WKyleGilbertson/L1IFStream/Card/pcbway/T-2P2W603942A.png

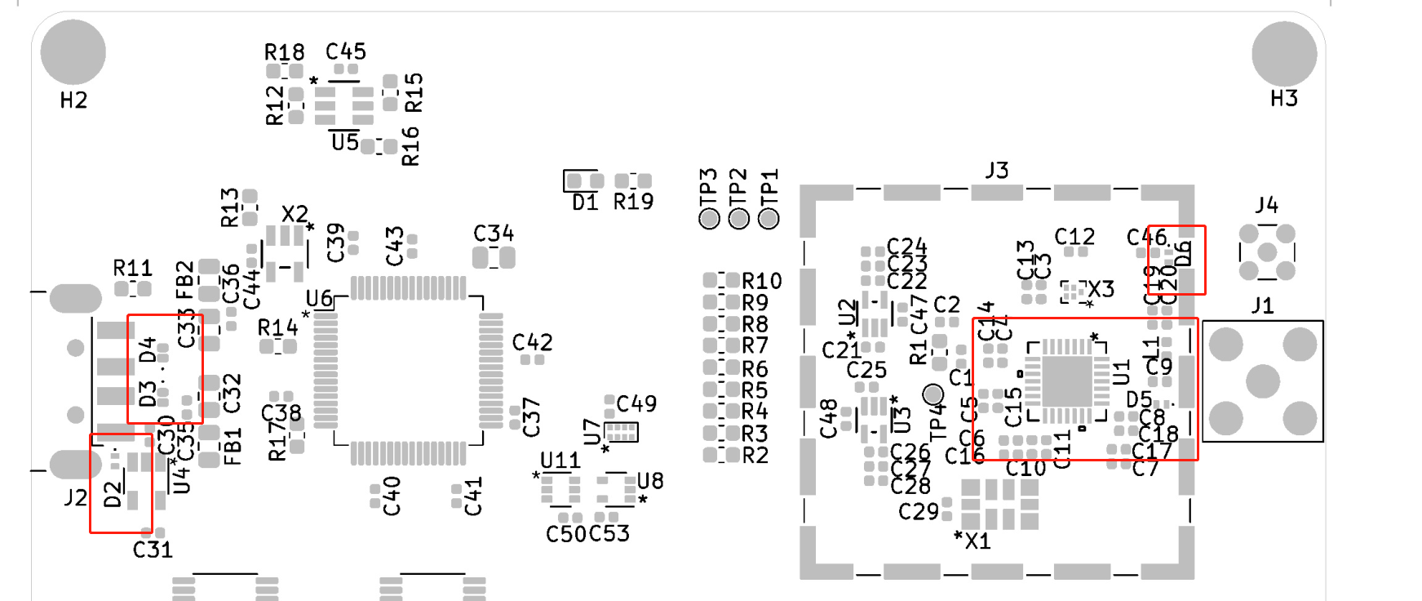
Card/pcbway/T-2P2W603942A.png
