WKyleGilbertson/L1IFStream/Card/pcbway/T-2P2W603942A-5sets-L1IFStream_BOM(2023-07-17-Corrected).xls

PCBWay Bom Quotation, Product No.:T-2P2W603942A
Item # | *Designator | *Qty | *Mfg Part # | Description / Value | Your Instructions / Notes | Substitute | *Unit Price (5 sets) | *Total | *Delivery Time | *Actual Purchase Mfg Part # | *PCBWay Note | Customer Reply | PCBWay Update
1 | C1 | 1 | 490-12651-1-ND | 27 pF『 』L1IFStream-rescue:C-MAX2769FT2232H『 』L1IFStream:C_0402_1005Metric『 』CAP CER 27PF 50V C0G/NP0 0402 5% |  |  | $0.125 | $0.625 |  | GCM1555C1H270JA16D
2 | C2, C9, C46 | 3 | 490-6242-1-ND | 470 pF『 』L1IFStream-rescue:C-MAX2769FT2232H『 』L1IFStream:C_0402_1005Metric『 』CAP CER 470PF 50V C0G/NP0 0402 10% |  |  | $0.051 | $0.765 | 7-10 Workdays | GRM1555C1H471JA01J
3 | C3, C4, C5, C6, C7, C8, C20, C23, C27, C29, C35, C36, C37, C38, C39, C40, C41, C42, C43, C44, C45, C49, C50, C51, C52, C53 | 26 | 490-6328-1-ND | 100 nF『 』L1IFStream-rescue:C-MAX2769FT2232H『 』L1IFStream:C_0402_1005Metric『 』CAP CER 0.1UF 16V X7R 0402 10% |  |  | $0.003 | $0.390 |  | GRM155R71C104KA88J
4 | C10, C11, C47, C48 | 4 | 399-7759-1-ND | 10 nF『 』L1IFStream-rescue:C-MAX2769FT2232H『 』L1IFStream:C_0402_1005Metric『 』CAP CER 10000PF 10V X7R 0402 10% |  |  | $0.050 | $1.000 | 7-10 Workdays | C0402C103K8RAC7867
5 | C12, C22, C26 | 3 |  |  |  |  |  |  |  |  | [DNP不要贴];
6 | C13, C14, C15, C16, C17, C18, C19 | 7 | 399-3194-1-ND | 100 pF『 』L1IFStream-rescue:C-MAX2769FT2232H『 』L1IFStream:C_0402_1005Metric『 』CAP CER 100PF 50V C0G/NP0 0402 5% |  |  | $0.034 | $1.190 | 7-10 Workdays | C0402C101J5GAC7867
7 | C21, C24, C25, C28, C30, C31 | 6 | 490-12233-1-ND | 1.0 uF『 』L1IFStream-rescue:C-MAX2769FT2232H『 』L1IFStream:C_0402_1005Metric『 』CAP CER 1UF 6.3V X6S 0402 |  |  | $0.053 | $1.590 |  | GRT155C80J105KE01D
8 | C32, C33 | 2 | 399-15725-1-ND | 4.7 uF『 』L1IFStream-rescue:C-MAX2769FT2232H『 』L1IFStream:C_0805_2012Metric『 』CAP CER 4.7UF 6.3V X7R 0805 |  |  | $0.453 | $4.530 | 7-10 Workdays | C0805C475J9RACAUTO
9 | C34 | 1 | 490-13309-1-ND | 3.3 uF『 』L1IFStream-rescue:C-MAX2769FT2232H『 』L1IFStream:C_0805_2012Metric『 』CAP CER 3.3UF 16V X7R 0805 |  |  | $0.344 | $1.720 |  | GCM21BR71C335KA73L
10 | D1 | 1 | QBLP601-AG1-2943 | LED『 』L1IFStream:LED_Small_Filled『 』L1IFStream:LED_0603_1608Metric | https://www.digikey.com/en/products/detail/qt-brightek-qtb/QBLP601-AG1-2943/14664280 |  | $0.619 | $3.095 | 7-10 Workdays | QBLP601-AG1-2943
11 | D2 | 1 | 296-TPD1E10B06QDPYRQ1DKR-ND | TPD1E10B06『 』L1IFStream:TPD1E10B06『 』L1IFStream:Texas_DPY0002A_0.6x1mm_P0.65mm『 』TVS DIODE 5.5VWM 14VC 2X1SON『 』14V (Typ) Clamp 6A (8/20Âµs) Ipp Tvs Diode Surface Mount 2-X1SON (1x.60) | https://www.ti.com/product/TPD1E10B06 | TPD1E10B06QDPYRQ1 | $0.328 | $1.640 |  | TPD1E10B06QDPYRQ1
12 | D3, D4 | 2 | 296-51108-6-ND | ESD321『 』L1IFStream:ESD321『 』L1IFStream:DPY-PX1SON_1.0mmx0.6mm『 』TVS DIODE 3.6VWM 6.8VC 2X1SON | https://www.ti.com/product/ESD321 | ESD321DPYR | $0.173 | $1.730 |  | ESD321DPYR
13 | D5, D6 | 2 | 296-TPD1E01B04DPYRQ1DKR-ND | TPD1E01B04『 』L1IFStream:TPD1E01B04『 』L1IFStream:Texas_DPY0002A_0.6x1mm_P0.65mm『 』AUTOMOTIVE 0.18-PF, 3.6-V, 15-KV『 』15V (Typ) Clamp 2.5A (8/20Âµs) Ipp Tvs Diode Surface Mount 2-X1SON (1x.60) | https://www.ti.com/product/TPD1E01B04 | TPD1E01B04DPYRQ1 | $0.300 | $3.000 |  | TPD1E01B04DPYRQ1
14 | FB1, FB2 | 2 | 490-1041-1-ND | Ferrite_Bead『 』L1IFStream-rescue:Ferrite_Bead-MAX2769FT2232H『 』L1IFStream:C_0805_2012Metric『 』FERRITE BEAD 1 KOHM 0805 1LN |  |  | $0.084 | $0.840 |  | BLM21AG102SN1D
15 | H1, H2, H3, H4 | 4 |  | MountingHole_Pad『 』L1IFStream-rescue:MountingHole_Pad-MAX2769FT2232H『 』L1IFStream:MountingHole_2.2mm_M2_Pad_Via |  |  |  |  |  |  | [DNP不要贴];
16 | J1 | 1 | ACX1232-ND | Conn_Coaxial『 』L1IFStream-rescue:Conn_Coaxial-MAX2769FT2232H『 』L1IFStream:SMA_Amphenol_132203-12_Horizontal『 』CONN SMA JACK R/A 50 OHM PCB | ~ |  | $6.160 | $30.800 |  | 132136
17 | J2 | 1 | WM3983CT-ND | USB_A『 』L1IFStream-rescue:USB_A-MAX2769FT2232H『 』L1IFStream:USB_A_CNCTech_1001-011-01101_Horizontal『 』CONN PLUG USB2.0 TYPEA 4P SMD RA | ~ |  | $1.044 | $5.220 |  | 0480372200
18 | J3 | 1 | 903-1008-1-ND | RF_Shield_One_Piece『 』L1IFStream-rescue:RF_Shield_One_Piece-MAX2769FT2232H『 』L1IFStream:Laird_Technologies_BMI-S-103_26.21x26.21mm『 』RF SHIELD 1.032X1.032 SLDR 1PC |  |  | $3.263 | $16.315 | 7-10 Workdays | BMI-S-103
19 | J4 | 1 | ARF1904-ND | Conn_Coaxial『 』L1IFStream-rescue:Conn_Coaxial-MAX2769FT2232H『 』L1IFStream:MMCX_Molex_73415-1471_Vertical『 』CONN MMCX JACK STR 50 OHM PCB | ~ |  | $21.661 | $108.305 | 7-10 Workdays | 908-22106
20 | L1 | 1 | 490-2629-1-ND | 33 nH『 』L1IFStream-rescue:L-MAX2769FT2232H『 』L1IFStream:L_0402_1005Metric『 』FIXED IND 33NH 350MA 580 MOHM |  |  | $0.203 | $1.015 |  | LQG15HS33NJ02D
21 | R1 | 1 | 2019-RK73H1JTTD2002FCT-ND | 20k『 』L1IFStream-rescue:R_US-MAX2769FT2232H『 』L1IFStream:R_0603_1608Metric『 』RES 20K OHM 1% 1/10W 0603 |  |  | $0.208 | $1.040 |  | RK73H1JTTD2002F
22 | R2, R4, R5, R7,R11 | 5 | 2019-RK73Z1JTTDCT-ND | NL『 』L1IFStream-rescue:R_US-MAX2769FT2232H『 』L1IFStream:R_0603_1608Metric『 』RES 0 OHM JUMPER 0603 |  |  | $0.017 | $0.425 | 7-10 Workdays | RK73Z1JTTD
23 | R3, R6, R8, R9, R10 |  |  |  |  |  |  |  |  |  | [DNP不要贴];
24 | R12 | 1 | 2019-RK73H1JTTD2201FCT-ND | 2.2k『 』L1IFStream-rescue:R_US-MAX2769FT2232H『 』L1IFStream:R_0603_1608Metric『 』RES 2.2K OHM 1% 1/10W 0603 |  |  | $0.139 | $0.695 |  | RK73H1JTTD2201F
25 | R13 | 1 | 2019-RK73H1JTTD1001FCT-ND | 1k『 』Device:R_US『 』L1IFStream:R_0603_1608Metric『 』RES 1K OHM 1% 1/8W 0603 | ~ |  | $0.139 | $0.695 |  | RK73H1JTTD1001F
26 | R14 | 1 | 2019-RK73H1JTTD1202FCT-ND | 12k『 』L1IFStream-rescue:R_US-MAX2769FT2232H『 』L1IFStream:R_0603_1608Metric『 』RES 12K OHM 1% 1/10W 0603 |  |  | $0.139 | $0.695 |  | RK73H1JTTD1202F
27 | R15, R16, R18 | 3 | 2019-RK73H1JTTD1002FCT-ND | 10k『 』L1IFStream-rescue:R_US-MAX2769FT2232H『 』L1IFStream:R_0603_1608Metric『 』RES 10K OHM 1% 1/10W 0603 |  |  | $0.032 | $0.480 | 7-10 Workdays | RK73H1JTTD1002F
28 | R17 | 1 | 2019-RK73H1JTTD1001FCT-ND | 1k『 』L1IFStream-rescue:R_US-MAX2769FT2232H『 』L1IFStream:R_0603_1608Metric『 』RES 1K OHM 1% 1/8W 0603 |  |  | $0.139 | $0.695 |  | RK73H1JTTD1001F
29 | R19 | 1 | 2019-RK73H1JTTD3300FDKR-ND | 330『 』L1IFStream-rescue:R_US-MAX2769FT2232H『 』L1IFStream:R_0603_1608Metric『 』RES 330 OHM 1% 1/8W 0603『 』330 Ohms ±1% 0.125W, 1/8W Chip Resistor 0603 (1608 Metric) Automotive AEC-Q200, Moisture Resistant Thick Film |  |  | $0.139 | $0.695 |  | RK73H1JTTD3300F
30 | TP1, TP2, TP3, TP4 | 4 |  | TestPoint『 』Connector:TestPoint『 』L1IFStream:TestPoint_Pad_D1.0mm | ~ |  |  |  |  |  | [DNP不要贴];
31 | U1 | 1 | 175-MAX2769BETI/V+-ND | MAX2769ETI+T『 』L1IFStream-rescue:MAX2769ETI+T-MAX2769FT2232H『 』L1IFStream:MAX2769ETI&plus_T『 』RF RX GNSS 1575.42MHZ 28TQFN『 』- RF Receiver GNSS, GPS 1575.42MHz PCB, Surface Mount 28-TQFN (5x5) | https://www.analog.com/media/en/technical-documentation/data-sheets/MAX2769B.pdf | MAX2769BETI/V+ | $3.753 | $18.765 |  | MAX2769BETI/V+T | MAX2769BETI/V+T is not available. We will supply MAX2769BETI/V+T ok?
32 | U2 | 1 | 296-19649-1-ND | TPS717285DCKR『 』:TPS717285DCKR-MAX2769FT2232H_1『 』L1IFStream:TPS717285DCKR『 』IC REG LINEAR 2.85V 150MA SC70-5 |  |  | $1.162 | $5.810 | 7-10 Workdays | TPS717285DCKR
33 | U3 | 1 | 296-19649-1-ND | TPS717285DCKR『 』L1IFStream-rescue:TPS717285DCKR-MAX2769FT2232H『 』L1IFStream:TPS717285DCKR『 』IC REG LINEAR 2.85V 150MA SC70-5 |  |  | $1.162 | $5.810 | 7-10 Workdays | TPS717285DCKR
34 | U4 | 1 | 488-NCP164CSN330T1GCT-ND | NCP164CSN330T1G『 』L1IFStream-rescue:NCP164CSN330T1G-MAX2769FT2232H『 』L1IFStream:TSOT-23-5『 』LDO 300 MA AD 3.3V, ULTRA | https://www.onsemi.com/pub/Collateral/NCP164C-D.PDF |  | $1.369 | $6.845 | 7-10 Workdays | NCP164CSN330T1G
35 | U5 | 1 | 93LC66BT-I/OTCT-ND | 93LC66BT-I_OT『 』L1IFStream-rescue:93LC66BT-I_OT-MAX2769FT2232H『 』L1IFStream:93LC66BT-I&slash_OT『 』IC EEPROM 4K SPI 2MHZ SOT23-6 |  |  | $0.538 | $2.690 | 7-10 Workdays | 93LC66BT-I/OT
36 | U6 | 1 | 768-1024-1-ND | FT2232H-Interface_USB『 』L1IFStream-rescue:FT2232H-Interface_USB-MAX2769FT2232H『 』L1IFStream:LQFP-64_10x10mm_P0.5mm『 』IC USB HS DUAL UART/FIFO 64-LQFP |  |  | $6.594 | $32.970 |  | FT2232HL-REEL
37 | U7 | 1 | 1727-3558-1-ND | 74LVC1G74『 』L1IFStream-rescue:74LVC1G74-MAX2769FT2232H『 』L1IFStream:SOT-833-1『 』IC FF D-TYPE SNGL 1BIT 8XSON | https://assets.nexperia.com/documents/data-sheet/74LVC1G74.pdf |  | $0.282 | $1.410 |  | 74LVC1G74GT,115
38 | U8 | 1 | 1727-2871-1-ND | 74LVC1G04『 』L1IFStream-rescue:74LVC1G04-MAX2769FT2232H『 』L1IFStream:SOT-353_SC-70-5『 』IC INVERTER 1CH 1-INP 5TSSOP | https://assets.nexperia.com/documents/data-sheet/74LVC1G04.pdf |  | $0.171 | $0.855 |  | 74LVC1G04GW,125
39 | U9, U10 | 2 | 1727-4034-1-ND | 74LVC374『 』L1IFStream-rescue:74LVC374-MAX2769FT2232H『 』L1IFStream:TSSOP-20_4.4x6.5mm_P0.65mm『 』IC FF D-TYPE SNGL 8BIT 20TSSOP | https://assets.nexperia.com/documents/data-sheet/74LVC374A.pdf |  | $0.259 | $2.590 |  | 74LVC374APW,118
40 | U11 | 1 | 1727-6915-6-ND | 74HC2G04『 』:74HC2G04-MAX2769FT2232H_2『 』L1IFStream:SOT-363_SC-70-6『 』IC INVERTER 2CH 2-INP 6TSSOP | https://assets.nexperia.com/documents/data-sheet/74HC_HCT2G04.pdf |  | $0.635 | $3.175 | 7-10 Workdays | 74HC2GU04GW,125 | We will supply 74HC2GU04GW,125,pls confirm.
41 | X1 | 1 | 1473-SIT5156AICFK-30N0-16.368000-ND | SIT5156『 』L1IFStream:SIT5156AICFA-30N0-16.368000_1『 』L1IFStream:10L_CQFN | https://www.sitime.com/support/resource-library/datasheets/sit5156-datasheet | SIT5156AICFK-30N0-16.368000 | $59.622 | $298.110 | 7-10 Workdays | SIT5156AICFK-30N0-16.368000
42 | X2 | 1 | 1473-SIT2024BA-S8-33E-12.000000G-ND | SIT2024BA-S8-33E-12.00000E『 』L1IFStream-rescue:SIT2024BA-S8-33E-12.00000E-MAX2769FT2232H『 』L1IFStream:SIT2024BA-S8-33E-12.000000E『 』MEMS OSC XO 12.0000MHZ LVCMOS LV |  |  |  |  |  | SIT2024BA-S8-33E-12.000000 | [Supplied by customer客供];
43 | X3 | 1 | 772-QPQ1060SR | QPQ1060『 』L1IFStream:QPQ1060『 』L1IFStream:QPQ1060_1.4x1.2 | https://www.qorvo.com/products/p/QPQ1060 |  |  |  |  | QPQ1060SR | [Supplied by customer客供];
 |  |  |  |  |  |  | Component Cost | $568.220
 |  |  |  |  |  |  | PCB cost | $277.670
 |  |  |  |  |  |  | Assembly cost | $30.000
 |  |  |  |  |  |  | PCBA in total | $875.890
