WKyleGilbertson/L1IFStream/Card/macrofab/L1IFStream_BOM.xlsx

Component Count: |  | 107
Collated Components:
Item | Description | Qty | Reference(s) | Value | Manufacturer | MPN | Vendor | Vendor P/N# | Notes
1 | CAP CER 27PF 50V C0G/NP0 0402 5% | 1 | C1 | 27 pF | Murata | GCM1555C1H270JA16D | DigiKey | 490-12651-1-ND
2 | CAP CER 470PF 50V C0G/NP0 0402 10% | 3 | C2, C9, C46 | 470 pF | Murata | GRM1555C1H471JA01J | DigiKey | 490-6242-1-ND
3 | CAP CER 0.1UF 16V X7R 0402 10% | 26 | C3, C4, C5, C6, C7, C8, C20, C23, C27, C29, C35, C36, C37, C38, C39, C40, C41, C42, C43, C44, C45, C49, C50, C51, C52, C53 | 100 nF | Murata | GRM155R71C104KA88J | DigiKey | 490-6328-1-ND
4 | CAP CER 10000PF 10V X7R 0402 10% | 4 | C10, C11, C47, C48 | 10 nF | Kemet | C0402C103K8RAC7867 | DigiKey | 399-7759-1-ND
5 | CAP CER 470PF 50V C0G/NP0 0402 10% | 3 | C12, C22, C26 | NL | DNP | DNP | DNP | DNP | DNP
6 | CAP CER 100PF 50V C0G/NP0 0402 5% | 7 | C13, C14, C15, C16, C17, C18, C19 | 100 pF | Kemet | C0402C101J5GAC7867 | DigiKey | 399-3194-1-ND
7 | CAP CER 1UF 6.3V X6S 0402 | 6 | C21, C24, C25, C28, C30, C31 | 1.0 uF | Murata | GRT155C80J105KE01D | DigiKey | 490-12233-1-ND
8 | CAP CER 4.7UF 6.3V X7R 0805 | 2 | C32, C33 | 4.7 uF | Kemet | C0805C475J9RACAUTO | DigiKey | 399-15725-1-ND
9 | CAP CER 3.3UF 16V X7R 0805 | 1 | C34 | 3.3 uF | Murata | GCM21BR71C335KA73L | DigiKey | 490-13309-1-ND
10 |  | 1 | D1 | LED | QTBrightek (QTB) | QBLP601-AG1-2943 | DigiKey | QBLP601-AG1-2943
11 | TVS DIODE 5.5VWM 14VC 2X1SON | 1 | D2 | TPD1E10B06 | Texas Instruments | TPD1E10B06QDPYRQ1 | DigiKey | 296-TPD1E10B06QDPYRQ1DKR-ND
12 | TVS DIODE 3.6VWM 6.8VC 2X1SON | 2 | D3, D4 | ESD321 | Texas Instruments | ESD321DPYR | DigiKey | 296-51108-6-ND
13 | AUTOMOTIVE 0.18-PF, 3.6-V, 15-KV | 2 | D5, D6 | TPD1E01B04 | Texas Instruments | TPD1E01B04DPYRQ1 | DigiKey | 296-TPD1E01B04DPYRQ1DKR-ND
14 | FERRITE BEAD 1 KOHM 0805 1LN | 2 | FB1, FB2 | Ferrite_Bead | Murata | BLM21AG102SN1D | DigiKey | 490-1041-1-ND
15 |  | 4 | H1, H2, H3, H4 | MountingHole_Pad | PCB MFR |  | MFR
16 | CONN SMA JACK R/A 50 OHM PCB | 1 | J1 | Conn_Coaxial | Amphenol RF | 132136 | DigiKey | ACX1232-ND
17 | CONN PLUG USB2.0 TYPEA 4P SMD RA | 1 | J2 | USB_A | Molex | 480372200 | DigiKey | WM3983CT-ND
18 | RF SHIELD 1.032"X1.032" SLDR 1PC | 1 | J3 | RF_Shield_One_Piece | Laird Technologies EMI | BMI-S-103 | DigiKey | 903-1008-1-ND
19 | CONN MMCX JACK STR 50 OHM PCB | 1 | J4 | Conn_Coaxial | Amphenol RF | 908-22106 | DigiKey | ARF1904-ND
20 | FIXED IND 33NH 350MA 580 MOHM | 1 | L1 | 33 nH | Murata | LQG15HS33NJ02D | DigiKey | 490-2629-1-ND
21 | RES 20K OHM 1% 1/10W 0603 | 1 | R1 | 20k | KOA Speer Electronics, Inc. | RK73H1JTTD2002F | DigiKey | 2019-RK73H1JTTD2002FCT-ND
22 | RES 0 OHM JUMPER 0603 | 5 | R2, R4, R5, R7, R11 | 0 | KOA Speer Electronics, Inc. | RK73Z1JTTD | DigiKey | 2019-RK73Z1JTTDCT-ND
23 | RES 0 OHM JUMPER 0603 | 5 | R3, R6, R8, R9, R10 | NL | DNP | DNP | DNP | DNP | DNP
24 | RES 2.2K OHM 1% 1/10W 0603 | 1 | R12 | 2.2k | KOA Speer Electronics, Inc. | RK73H1JTTD2201F | DigiKey | 2019-RK73H1JTTD2201FCT-ND
25 | RES 1K OHM 1% 1/8W 0603 | 1 | R13 | 1k | KOA Speer Electronics, Inc. | RK73H1JTTD1001F | DigiKey | 2019-RK73H1JTTD1001FCT-ND
26 | RES 12K OHM 1% 1/10W 0603 | 1 | R14 | 12k | KOA Speer Electronics, Inc. | RK73H1JTTD1202F | DigiKey | 2019-RK73H1JTTD1202FCT-ND
27 | RES 10K OHM 1% 1/10W 0603 | 3 | R15, R16, R18 | 10k | KOA Speer Electronics, Inc. | RK73H1JTTD1002F | DigiKey | 2019-RK73H1JTTD1002FCT-ND
28 | RES 1K OHM 1% 1/8W 0603 | 1 | R17 | 1k | KOA Speer Electronics, Inc. | RK73H1JTTD1001F | DigiKey | 2019-RK73H1JTTD1001FCT-ND
29 | RES 330 OHM 1% 1/8W 0603 | 1 | R19 | 330 | KOA Speer Electronics, Inc. | RK73H1JTTD3300F | DigiKey | 2019-RK73H1JTTD3300FDKR-ND
30 |  | 4 | TP1, TP2, TP3, TP4 | TestPoint | PCB MFR |  | MFR
31 | RF RX GNSS 1575.42MHZ 28TQFN | 1 | U1 | MAX2769ETI+T | Analog Devices Inc./ Maxim Integrated | MAX2769BETI/V+ | DigiKey | 175-MAX2769BETI/V+-ND
32 | IC REG LINEAR 2.85V 150MA SC70-5 | 2 | U2, U3 | TPS717285DCKR | Texas Instruments | TPS717285DCKR | DigiKey | 296-19649-1-ND
33 | LDO 300 MA AD 3.3V, ULTRA | 1 | U4 | NCP164CSN330T1G | Onsemi | NCP164CSN330T1G | DigiKey | 488-NCP164CSN330T1GCT-ND
34 | IC EEPROM 4K SPI 2MHZ SOT23-6 | 1 | U5 | 93LC66BT-I_OT | Microchip | 93LC66BT-I/OT | DigiKey | 93LC66BT-I/OTCT-ND
35 | IC USB HS DUAL UART/FIFO 64-LQFP | 1 | U6 | FT2232H-Interface_USB | FTDI | FT2232HL-REEL | DigiKey | 768-1024-1-ND
36 | IC FF D-TYPE SNGL 1BIT 8XSON | 1 | U7 | 74LVC1G74 | Nexperia | 74LVC1G74GT,115 | DigiKey | 1727-3558-1-ND
37 | IC INVERTER 1CH 1-INP 5TSSOP | 1 | U8 | 74LVC1G04 | Nexperia | 74LVC1G04GW,125 | DigiKey | 1727-2871-1-ND
38 | IC FF D-TYPE SNGL 8BIT 20TSSOP | 2 | U9, U10 | 74LVC374 | Nexperia | 74LVC374APW,118 | DigiKey | 1727-4034-1-ND
39 | IC INVERTER 2CH 2-INP 6TSSOP | 1 | U11 | 74HC2GU04 | Nexperia | 74HC2GU04GW,125 | DigiKey | 1727-6915-6-ND
40 | MEMS OSC TCXO 16.3680MHZ | 1 | X1 | SIT5156 | SiTime | SIT5156AICFK-30N0-16.368000 | DigiKey | 1473-SIT5156AICFK-30N0-16.368000-ND
41 | MEMS OSC XO 12.0000MHZ LVCMOS LV | 1 | X2 | SIT2024BA-S8-33E-12.00000E | SiTime | SIT2024BA-S8-33E-12.000000 | DigiKey | 1473-SIT2024BA-S8-33E-12.000000G-ND
42 | Signal Conditioning L1 TC-SAW, GSO | 1 | X3 | QPQ1060 | Qorvo | QPQ1060SR | Mouser | 772-QPQ1060SR
Source: |  | C:\git\GPS\L1IFStream\Card\L1IFStream.kicad_sch
Date: |  | 2023-07-12 10:48
Tool: |  | Eeschema 7.0.6
Generator: |  | C:\Programs\KiCad\7.0\bin\scripting\plugins/bom_csv_grouped_by_value.py
