WKyleGilbertson/L1IFStream/Card/pcbway/parts.txt

5 maxim chips
5 qorvo chips
5 SiTime chips
