WKyleGilbertson/L1IFStream/Card/STEP/TSSOP-20_4.4x6.5mm_P0.65mm.step

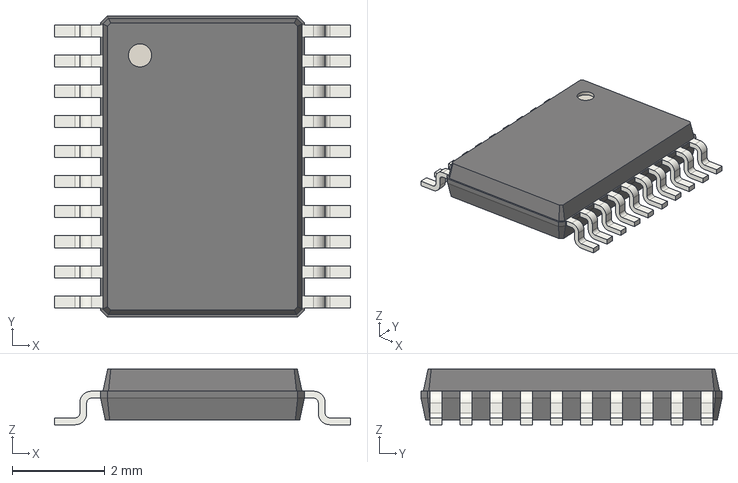
[picture p2: CAD file, 2023-11-13]
Card/STEP/TSSOP-20_4.4x6.5mm_P0.65mm.step
6.40 x 6.50 x 1.20 mm
