WKyleGilbertson/L1IFStream/Card/STEP/SOT833-1.step

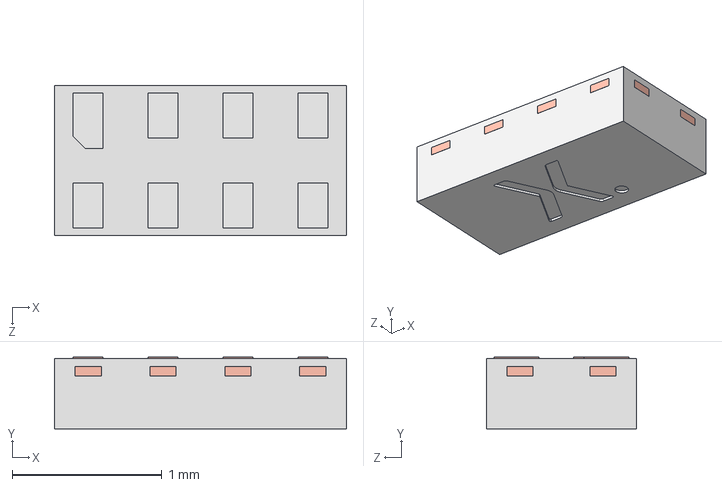
[picture p3: CAD file, 2023-11-13]
Card/STEP/SOT833-1.step
1.95 x 0.48 x 1.00 mm
SOT833-1 LF
SOT833-1 Mold body
