WKyleGilbertson/L1IFStream/Card/STEP/SOT-363_SC-70-6.step

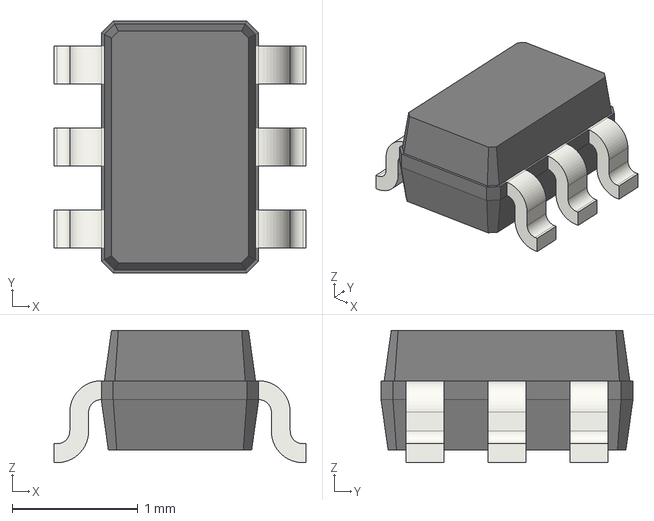
[picture p4: CAD file, 2023-11-13]
Card/STEP/SOT-363_SC-70-6.step
2.00 x 2.00 x 1.05 mm
