WKyleGilbertson/L1IFStream/Card/STEP/SOT-353_SC-70-5.step

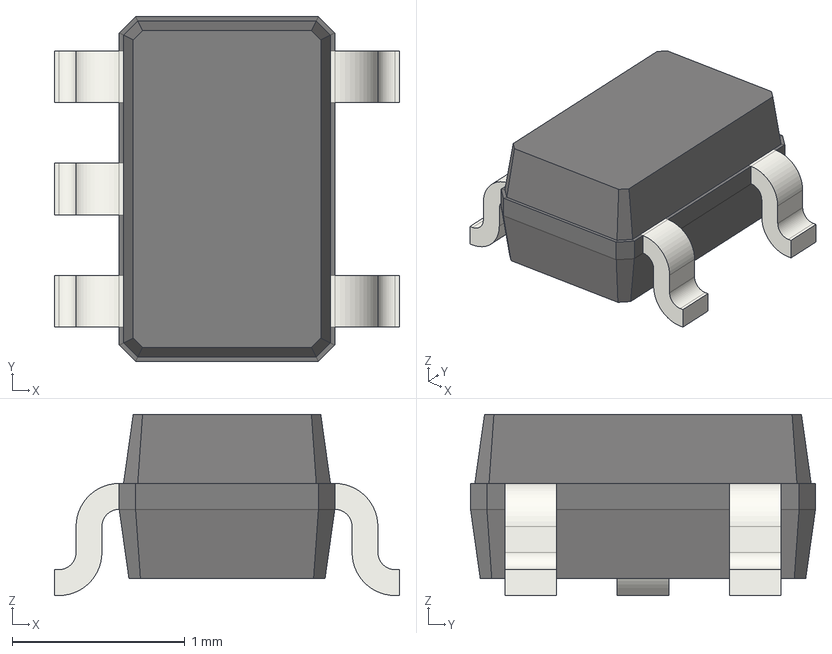
[picture p5: CAD file, 2023-11-13]
Card/STEP/SOT-353_SC-70-5.step
2.00 x 2.00 x 1.05 mm
