WKyleGilbertson/L1IFStream/Card/STEP/MMCX_Molex_73415-1471_Vertical.step

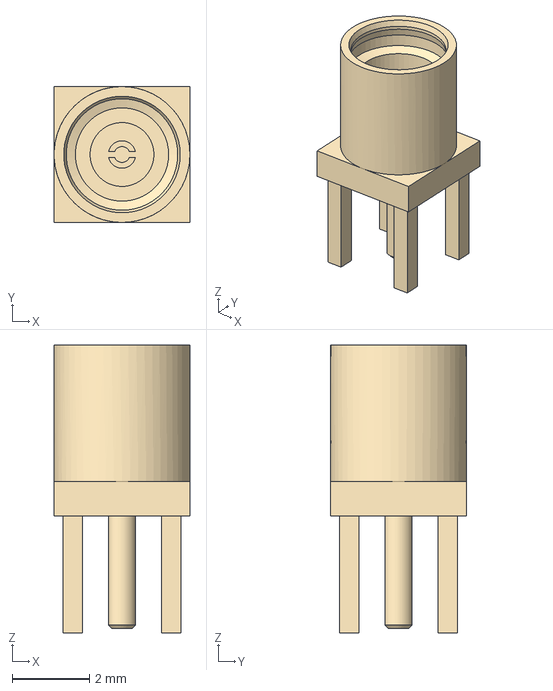
[picture p6: CAD file, 2023-11-13]
Card/STEP/MMCX_Molex_73415-1471_Vertical.step
3.51 x 3.51 x 7.44 mm
