WKyleGilbertson/L1IFStream/Card/STEP/LQFP-64_10x10mm_P0.5mm.step

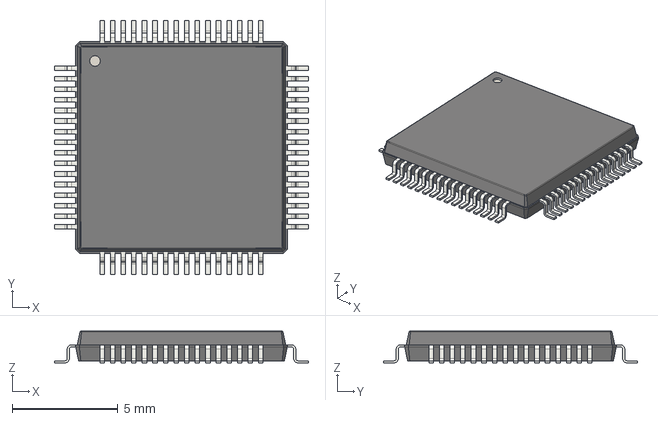
[picture p7: CAD file, 2023-11-13]
Card/STEP/LQFP-64_10x10mm_P0.5mm.step
12.0 x 12.0 x 1.50 mm
