WKyleGilbertson/L1IFStream/Card/STEP/DCK0005A.stp

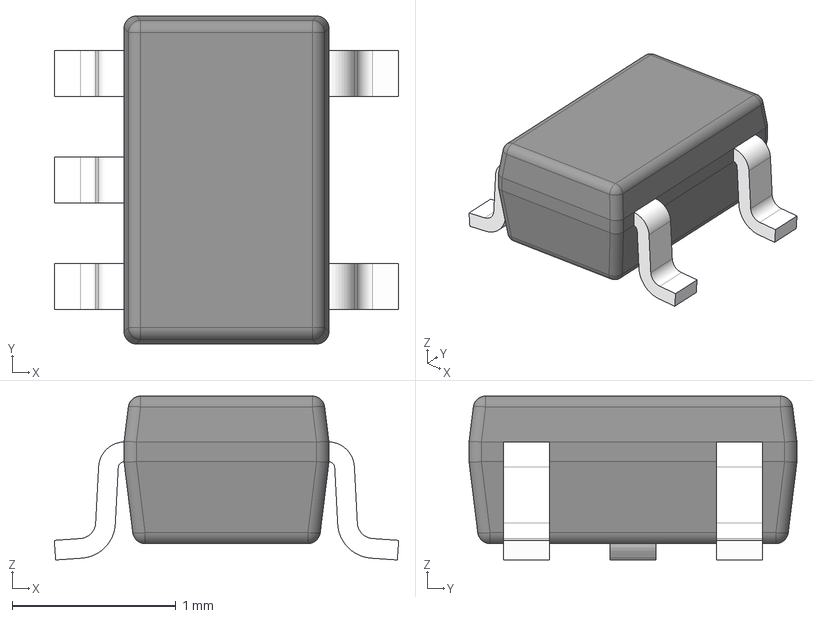
[picture p8: CAD file, 2023-11-09]
Card/STEP/DCK0005A.stp
2.10 x 2.00 x 1.00 mm
BODY-SOT
LEAD-SOT x 5
PIN1-ID
