WKyleGilbertson/L1IFStream/Card/STEP/Laird-BMI-S-103-1.STEP

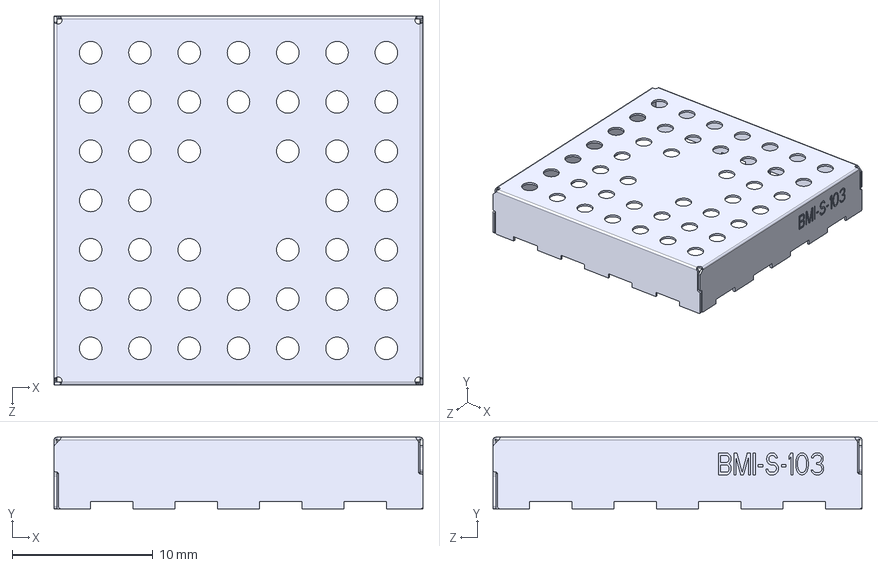
[picture p9: CAD file, 2023-07-18]
Card/STEP/Laird-BMI-S-103-1.STEP
26.2 x 5.08 x 26.2 mm
