WKyleGilbertson/L1IFStream/Card/STEP/QFN-28-1EP_5x5mm_P0.5mm_EP3.35x3.35mm.step

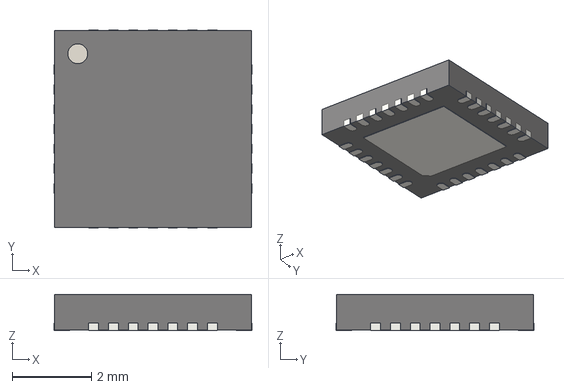
[picture p10: CAD file, 2023-07-18]
Card/STEP/QFN-28-1EP_5x5mm_P0.5mm_EP3.35x3.35mm.step
5.00 x 5.00 x 0.92 mm
