WKyleGilbertson/L1IFStream/Card/STEP/SOT-23-6.step

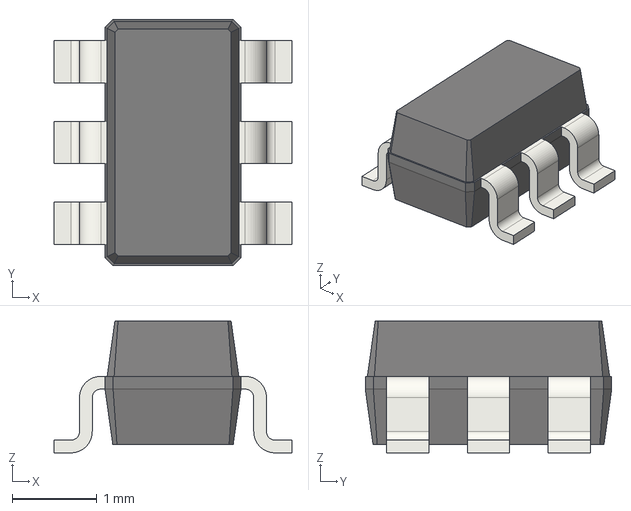
[picture p11: CAD file, 2023-07-18]
Card/STEP/SOT-23-6.step
2.80 x 2.90 x 1.55 mm
