WKyleGilbertson/L1IFStream/Card/STEP/Oscillator_SMD_IDT_JS6-6_5.0x3.2mm_P1.27mm.step

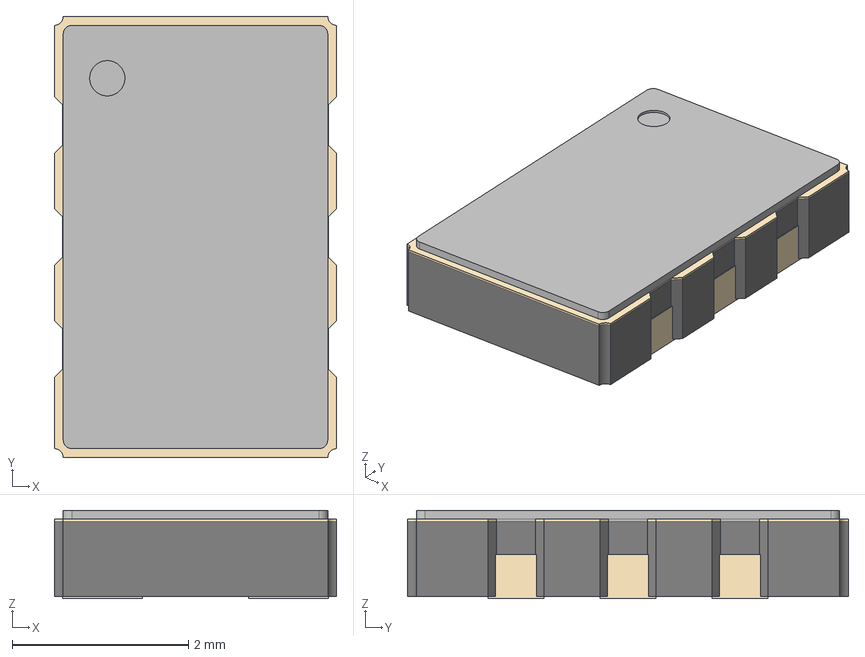
[picture p12: CAD file, 2023-07-18]
Card/STEP/Oscillator_SMD_IDT_JS6-6_5.0x3.2mm_P1.27mm.step
3.20 x 5.00 x 1.00 mm
