WKyleGilbertson/L1IFStream/Card/STEP/SOT-23-5.step

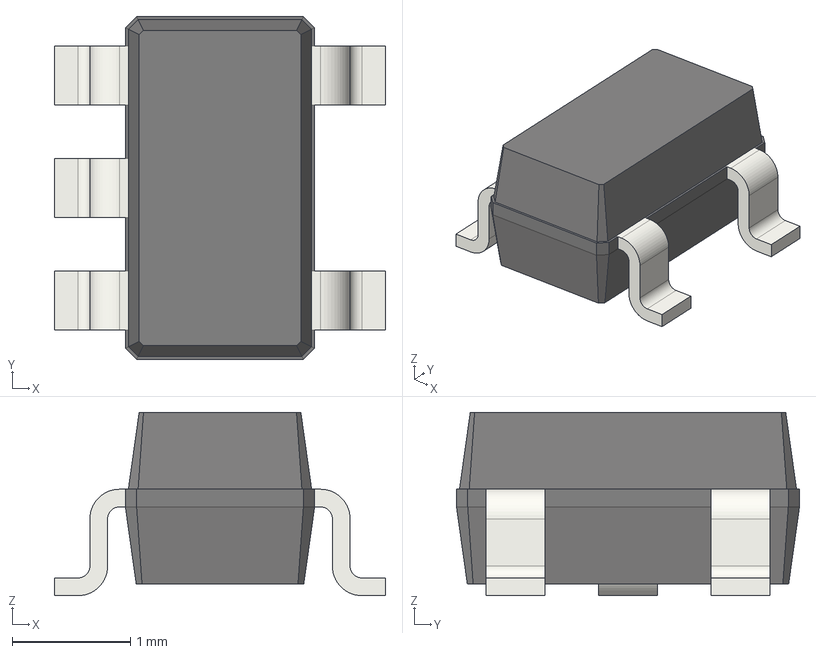
[picture p13: CAD file, 2023-07-18]
Card/STEP/SOT-23-5.step
2.80 x 2.90 x 1.55 mm
