WKyleGilbertson/L1IFStream/Card/STEP/DPY0002A.stp

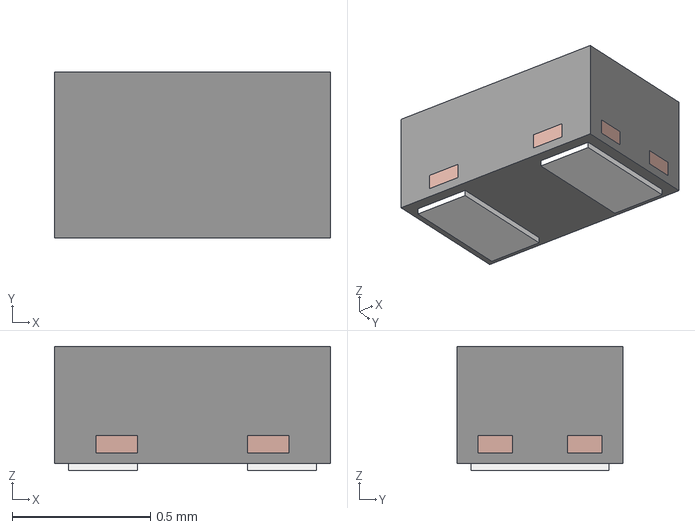
[picture p14: CAD file, 2023-07-18]
Card/STEP/DPY0002A.stp
1.00 x 0.6 x 0.45 mm
BODY-SON
FRAME-DPY0002A
