WKyleGilbertson/L1IFStream/Card/STEP/QPQ1060SR.stp

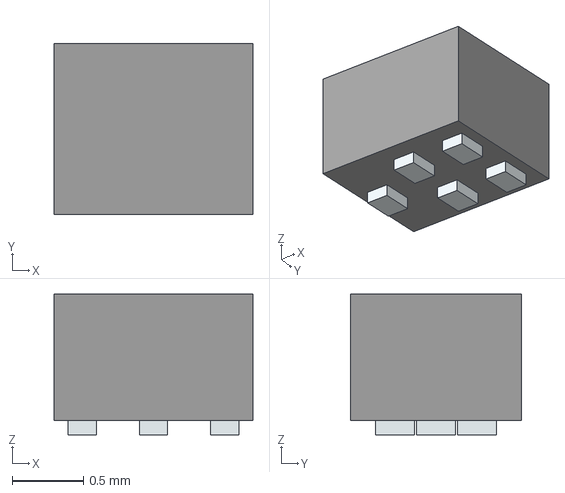
[picture p15: CAD file, 2023-07-13]
Card/STEP/QPQ1060SR.stp
1.40 x 1.20 x 0.99 mm
Pins
