WKyleGilbertson/L1IFStream/Card/STEP/SMA-J-P-X-RA-TH1.step

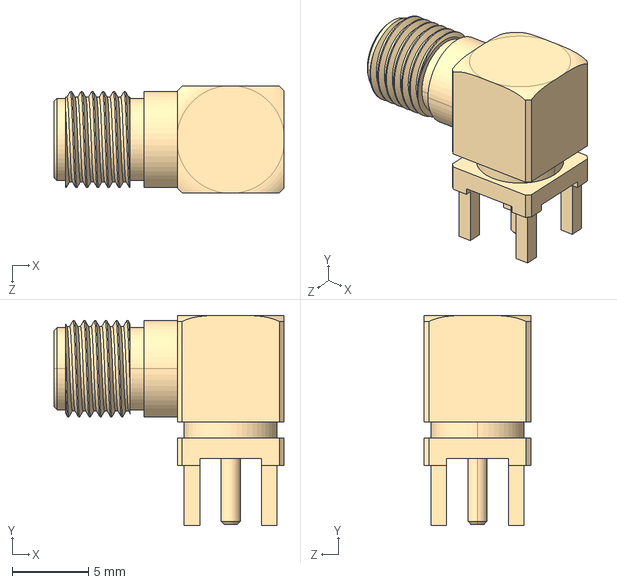
[picture p16: CAD file, 2023-07-10]
Card/STEP/SMA-J-P-X-RA-TH1.step
15.1 x 13.8 x 7.00 mm
