WKyleGilbertson/L1IFStream/Card/STEP/1001-011-01101.STEP

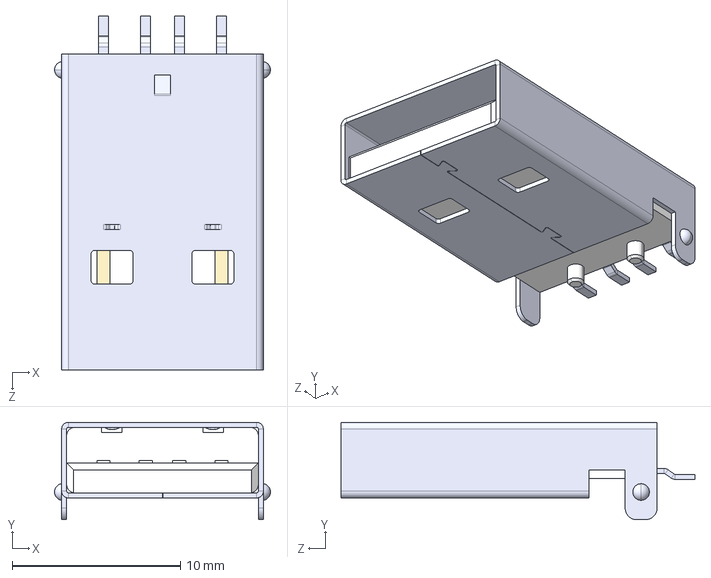
[picture p17: CAD file, 2023-07-10]
Card/STEP/1001-011-01101.STEP
12.8 x 5.80 x 21.1 mm
