WKyleGilbertson/L1IFStream/Card/macrofab/Assy.pdf

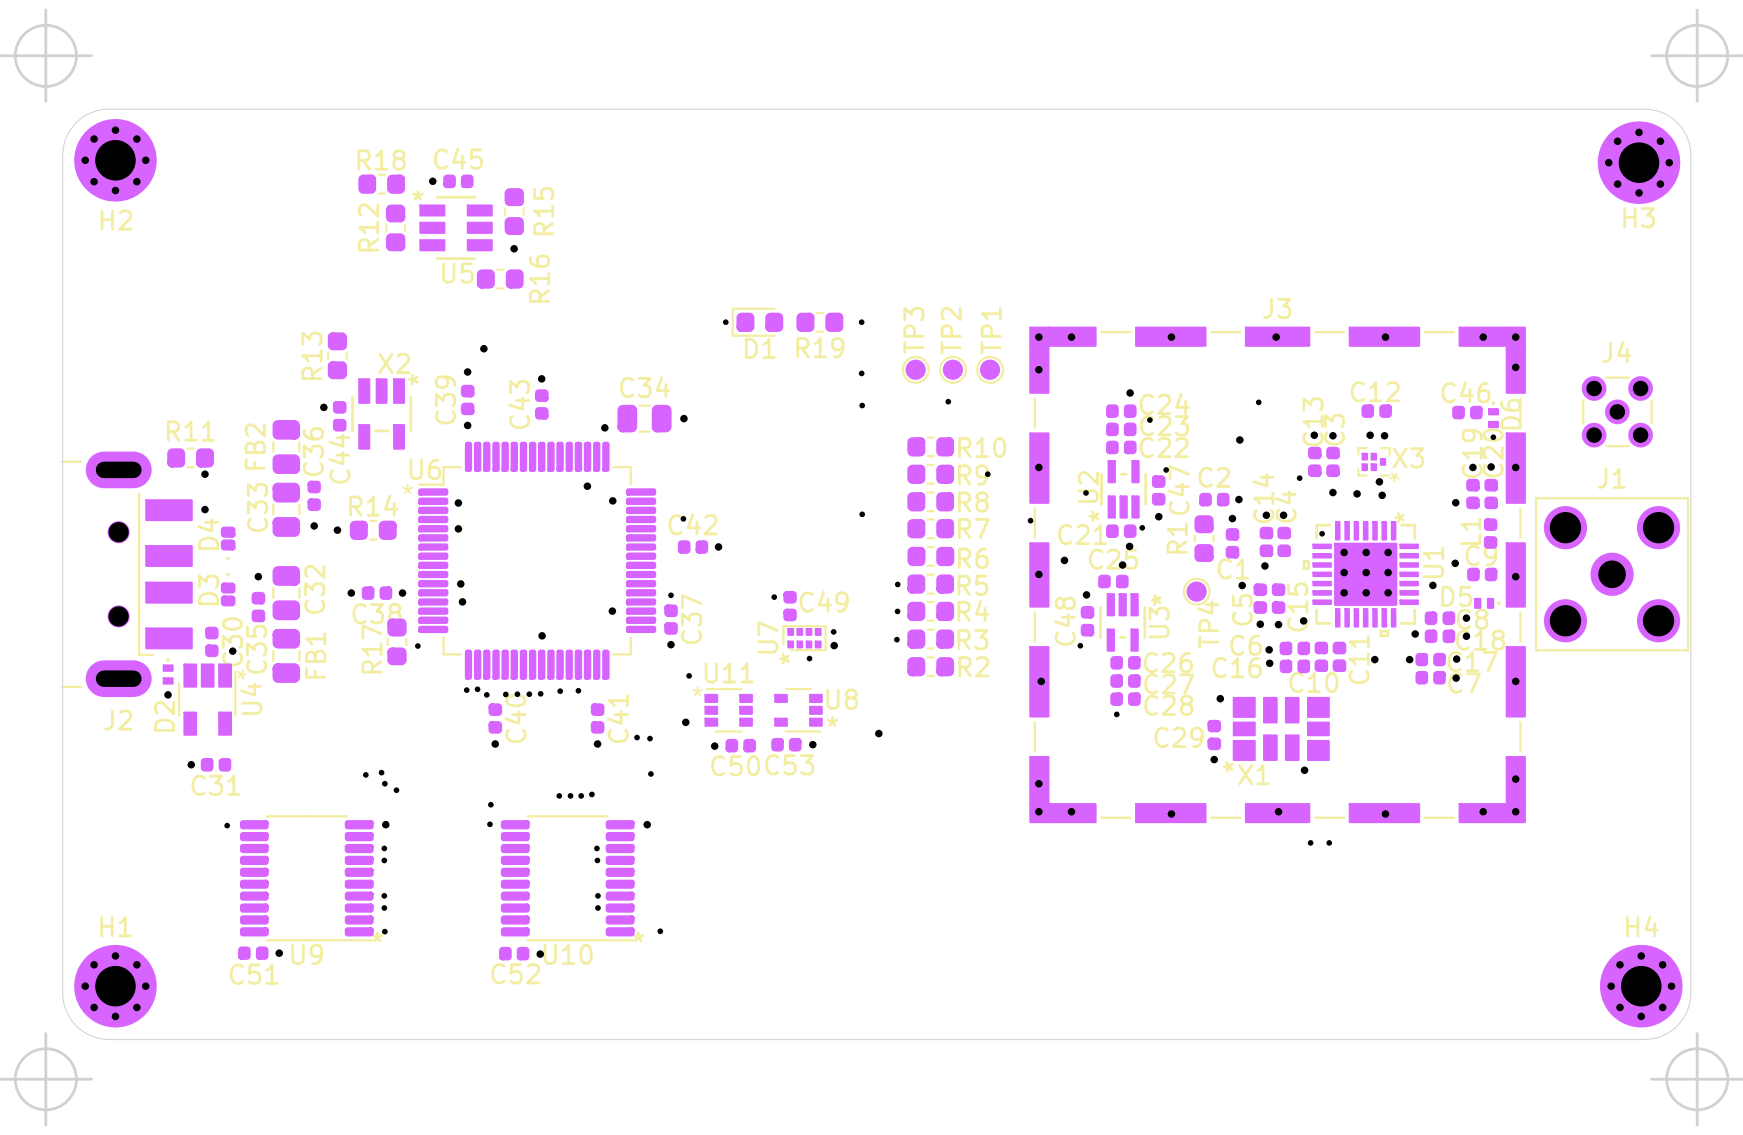
[picture p19: page 1]
