WKyleGilbertson/L1IFStream/Card/L1IFStream.kicad_pcb

## KiCad design Card/L1IFStream.kicad_pcb (2024-02-13)

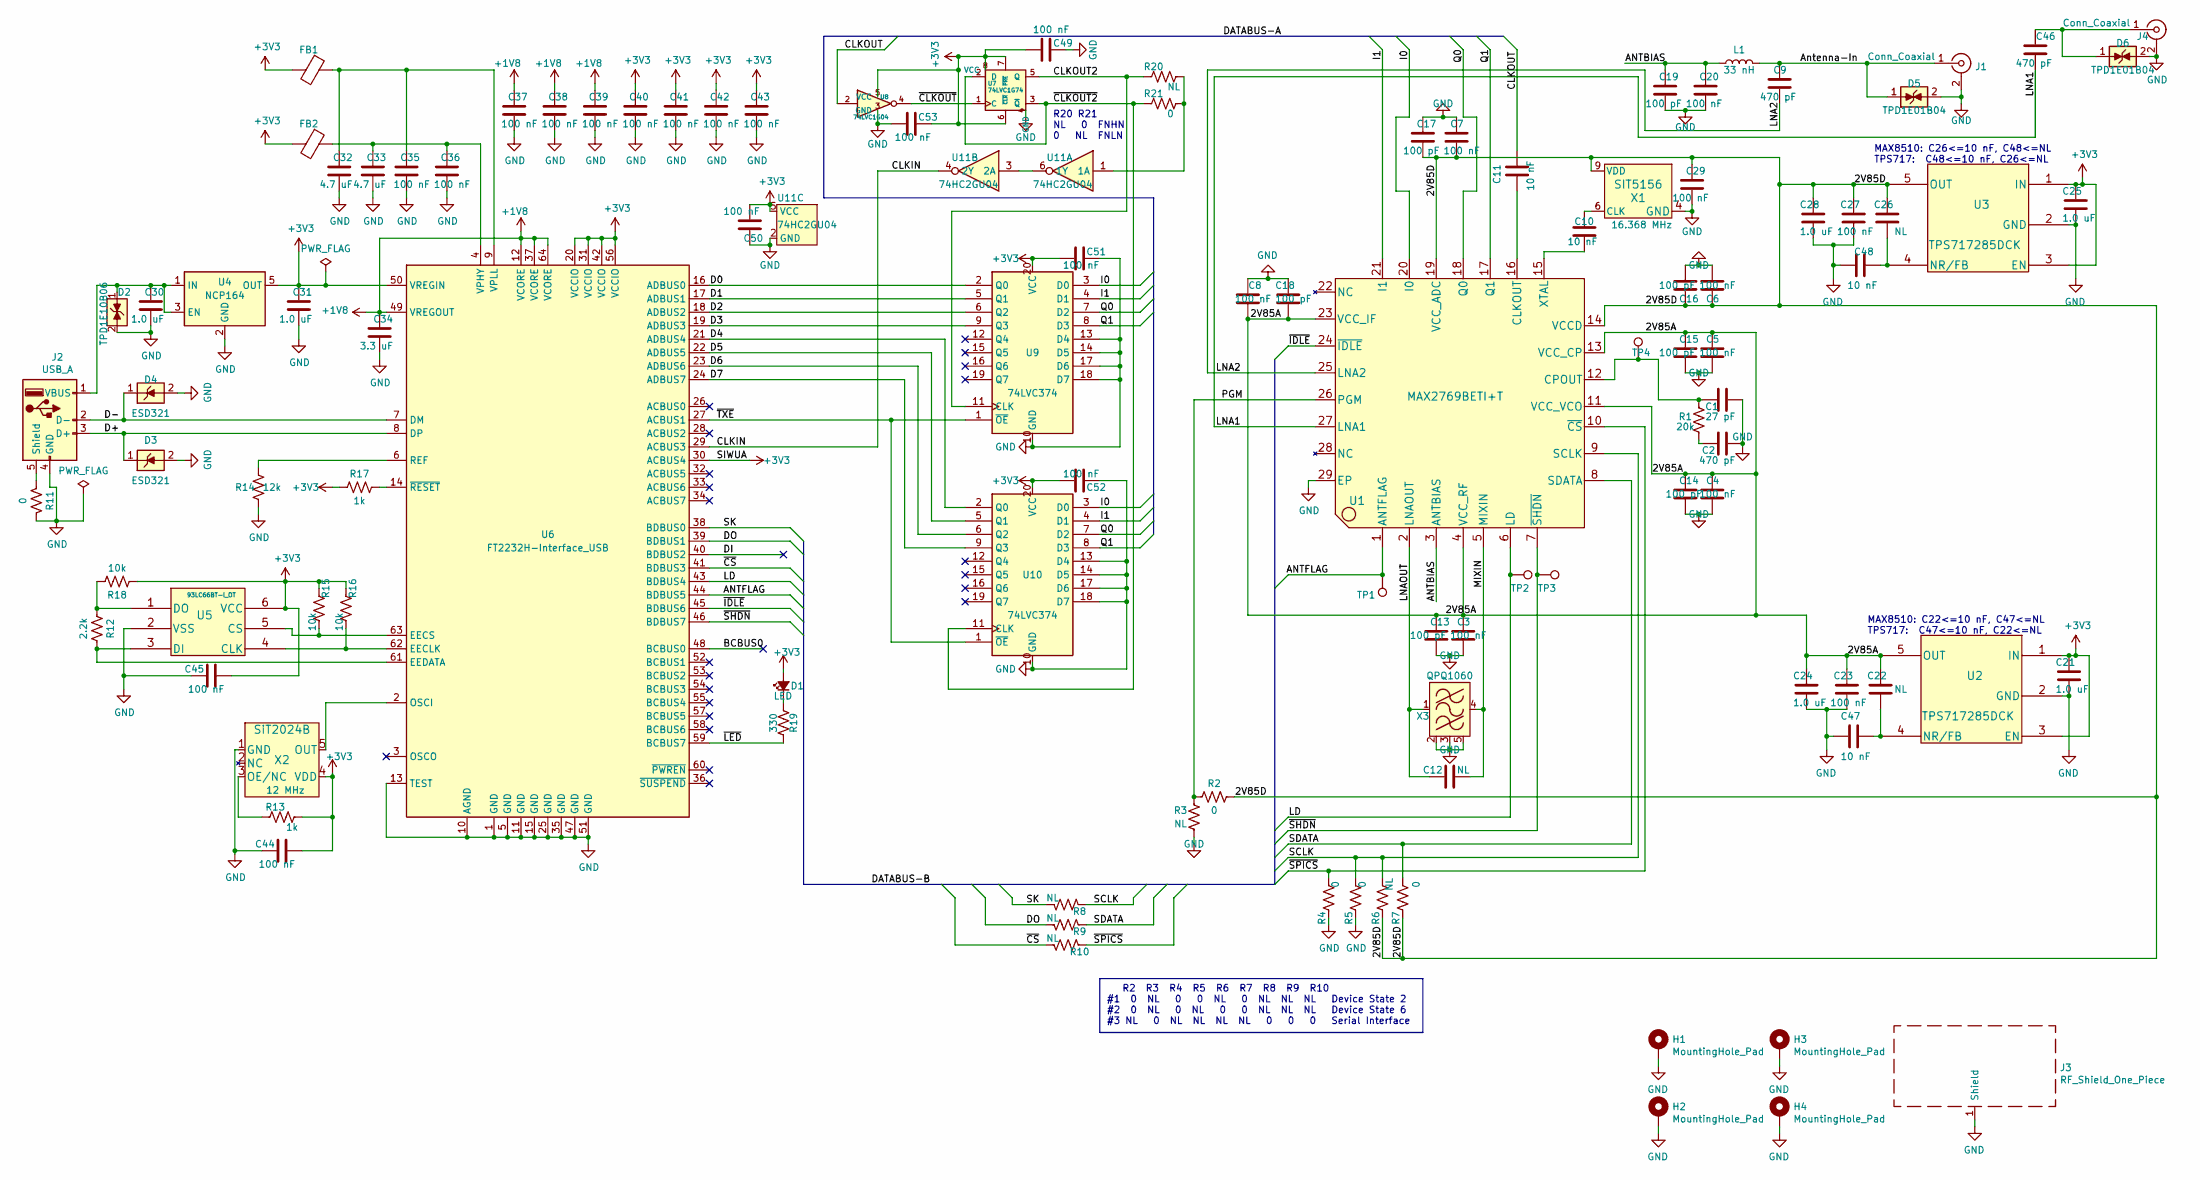
[picture p20: schematic L1IFStream.kicad_sch, L1 IF Stream]

Parts:
C1: 27 pF; C_0402_1005Metric; MPN GCM1555C1H270JA16D
C2, C9, C46: 470 pF; C_0402_1005Metric; MPN GRM1555C1H471JA01J
C3, C4, C5, C6, C7, C8, C20, C23, C27, C29, C35, C36, C37, C38, C39, C40, C41, C42, C43, C44, C45, C49, C50, C51, C52, C53: 100 nF; C_0402_1005Metric; MPN GRM155R71C104KA88J
C10, C11, C47, C48: 10 nF; C_0402_1005Metric; MPN C0402C103K8RAC7867
C12: NL; C_0402_1005Metric; MPN GRM1555C1H471JA01J
C13, C14, C15, C16, C17, C18, C19: 100 pF; C_0402_1005Metric; MPN C0402C101J5GAC7867
C21, C24, C25, C28, C30, C31: 1.0 uF; C_0402_1005Metric; MPN GRT155C80J105KE01D
C22, C26: NL; C_0402_1005Metric; MPN C0402C103K8RAC7867
C32, C33: 4.7 uF; C_0805_2012Metric; MPN C0805C475J9RACAUTO
C34: 3.3 uF; C_0805_2012Metric; MPN GCM21BR71C335KA73L
D1: LED; LED_0603_1608Metric; MPN QBLP601-AG1-2943
D2: TPD1E10B06; Texas_DPY0002A_0.6x1mm_P0.65mm; MPN TPD1E10B06QDPYRQ1
D3, D4: ESD321; Texas_DPY0002A_0.6x1mm_P0.65mm; MPN ESD321DPYR
D5, D6: TPD1E01B04; Texas_DPY0002A_0.6x1mm_P0.65mm; MPN TPD1E01B04DPYRQ1
FB1, FB2: Ferrite_Bead; C_0805_2012Metric; MPN BLM21AG102SN1D
H1, H2, H3, H4: MountingHole_Pad; MountingHole_2.2mm_M2_Pad_Via
J1: Conn_Coaxial; SMA_Amphenol_132203-12_Horizontal; MPN 132136
J2: USB_A; USB_A_CNCTech_1001-011-01101_Horizontal; MPN 0480372200
J3: RF_Shield_One_Piece; Laird_Technologies_BMI-S-103_26.21x26.21mm; MPN BMI-S-103
J4: Conn_Coaxial; MMCX_Molex_73415-1471_Vertical; MPN 908-22106
L1: 33 nH; L_0402_1005Metric; MPN LQG15HS33NJ02D
R1: 20k; R_0603_1608Metric; MPN RK73H1JTTD2002F
R2, R4, R5, R7, R11, R21: 0; R_0603_1608Metric; MPN RK73Z1JTTD
R3, R6, R8, R9, R10, R20: NL; R_0603_1608Metric; MPN RK73Z1JTTD
R12: 2.2k; R_0603_1608Metric; MPN RK73H1JTTD2201F
R13, R17: 1k; R_0603_1608Metric; MPN RK73H1JTTD1001F
R14: 12k; R_0603_1608Metric; MPN RK73H1JTTD1202F
R15, R16, R18: 10k; R_0603_1608Metric; MPN RK73H1JTTD1002F
R19: 330; R_0603_1608Metric; MPN RK73H1JTTD3300F
TP1, TP2, TP3, TP4: TestPoint; TestPoint_Pad_D1.0mm
U1: MAX2769BETI+T; QFN-28_EP_5.63x5.63_Pitch0.5mm; MPN MAX2769BETI/V+
U2, U3: TPS717285DCK; MPN TPS717285DCK
U4: NCP164; TSOP-5; MPN NCP164CSN330T1G
U5: 93LC66BT-I_OT; SOT-23-6; MPN 93LC66BT-I/OT
U6: FT2232H-Interface_USB; LQFP-64_10x10mm_P0.5mm; MPN FT2232HL-REEL
U7: 74LVC1G74; SOT-833-1; MPN 74LVC1G74GT,115
U8: 74LVC1G04; SOT-353_SC-70-5; MPN 74LVC1G04GW,125
U9, U10: 74LVC374; TSSOP-20_4.4x6.5mm_P0.65mm; MPN 74LVC374APW,118
U11: 74HC2GU04; SOT-363_SC-70-6; MPN 74HC2GU04GW,125
X1: SIT5156; 10L_CQFN; MPN SIT5156AICFK-30N0-16.368000
X2: SiT2024B; SOT-23-5; MPN SIT2024BA-S8-33E-12.000000
X3: QPQ1060; QPQ1060_1.4x1.2; MPN QPQ1060SR

Connections:
+1V8: C34.1, C37.1, C38.1, C39.1, U6.12 (VCORE), U6.37 (VCORE), U6.49 (VREGOUT), U6.64 (VCORE)
+3V3: C21.1, C25.1, C31.1, C40.1, C41.1, C42.1, C43.1, C44.2, C45.2, C49.2, C50.2, C51.1, C52.1, C53.2, D1.2 (A), FB1.2, FB2.2, R13.1, R15.2, R16.2, R17.2, R18.2, U2.1 (IN), U2.3 (EN), U3.1 (IN), U3.3 (EN), U4.5 (OUT), U5.6 (VCC), U6.20 (VCCIO), U6.30 (ACBUS4), U6.31 (VCCIO), U6.42 (VCCIO), U6.50 (VREGIN), U6.56 (VCCIO), U7.6 (~CLR), U7.7 (~PRE), U7.8 (VCC), U8.5 (VCC), U9.20 (VCC), U10.20 (VCC), U11.5 (VCC), X2.4 (VDD)
/2V85A: C3.1, C4.1, C5.1, C8.2, C13.1, C14.1, C15.1, C18.2, C22.1, C23.1, C24.1, U1.4 (VCC_RF), U1.11 (VCC_VCO), U1.13 (VCC_CP), U1.23 (VCC_IF), U2.5 (OUT)
/2V85D: C6.1, C7.2, C16.1, C17.2, C26.1, C27.1, C28.1, C29.1, R2.1, R6.2, R7.2, U1.14 (VCCD), U1.19 (VCC_ADC), U3.5 (OUT), X1.9 (VDD)
/ANTBIAS: C19.1, C20.1, L1.1, U1.3 (ANTBIAS)
/ANTFLAG: TP1.1, U1.1 (ANTFLAG), U6.44 (BDBUS5)
/Antenna-In: C9.1, D5.1 (K), J1.1 (In), L1.2
/BCBUS0: U6.48 (BCBUS0)
/CLKIN: U6.29 (ACBUS3), U11.4 (2Y)
/CLKOUT: C11.1, U8.2
/CLKOUT2: R20.2, U7.5 (Q), U9.11 (CLK)
/D0: U6.16 (ADBUS0), U9.2 (Q0)
/D1: U6.17 (ADBUS1), U9.5 (Q1)
/D2: U6.18 (ADBUS2), U9.6 (Q2)
/D3: U6.19 (ADBUS3), U9.9 (Q3)
/D4: U6.21 (ADBUS4), U10.2 (Q0)
/D5: U6.22 (ADBUS5), U10.5 (Q1)
/D6: U6.23 (ADBUS6), U10.6 (Q2)
/D7: U6.24 (ADBUS7), U10.9 (Q3)
/D+: D3.1 (K), J2.3 (D+), U6.8 (DP)
/D-: D4.1 (K), J2.2 (D-), U6.7 (DM)
/DI: U6.40 (BDBUS2)
/DO: R9.2, U6.39 (BDBUS1)
/I0: U1.20 (I0), U9.3 (D0), U10.3 (D0)
/I1: U1.21 (I1), U9.4 (D1), U10.4 (D1)
/LD: TP2.1, U1.6 (LD), U6.43 (BDBUS4)
/LNA1: C46.2, U1.27 (LNA1)
/LNA2: C9.2, U1.25 (LNA2)
/LNAOUT: C12.1, U1.2 (LNAOUT), X3.1 (IN)
/MIXIN: C12.2, U1.5 (MIXIN), X3.4 (OUT)
/PGM: R2.2, R3.2, U1.26 (PGM)
/Q0: U1.18 (Q0), U9.7 (D2), U10.7 (D2)
/Q1: U1.17 (Q1), U9.8 (D3), U10.8 (D3)
/SCLK: R5.2, R6.1, R8.1, U1.9 (SCLK)
/SDATA: R7.1, R9.1, U1.8 (SDATA)
/SK: R8.2, U6.38 (BDBUS0)
/~CLKOUT2: R21.2, U7.2 (D), U7.3 (~Q), U10.11 (CLK)
/~CLKOUT: U7.1 (C), U8.4
/~CS: R10.2, U6.41 (BDBUS3)
/~IDLE: U1.24 (~IDLE), U6.45 (BDBUS6)
/~LED: R19.2, U6.59 (BCBUS7)
/~SHDN: TP3.1, U1.7 (~SHDN), U6.46 (BDBUS7)
/~SPICS: R4.2, R10.1, U1.10 (~CS)
/~TXE: U6.27 (ACBUS1), U9.1 (~OE), U10.1 (~OE)
GND: C1.2, C2.2, C3.2, C4.2, C5.2, C6.2, C7.1, C8.1, C13.2, C14.2, C15.2, C16.2, C17.1, C18.1, C19.2, C20.2, C21.2, C23.2, C24.2, C25.2, C27.2, C28.2, C29.2, C30.2, C31.2, C32.2, C33.2, C34.2, C35.2, C36.2, C37.2, C38.2, C39.2, C40.2, C41.2, C42.2, C43.2, C44.1, C45.1, C47.2, C48.2, C49.1, C50.1, C51.2, C52.2, C53.1, D2.2 (A), D3.2 (A), D4.2 (A), D5.2 (A), D6.2 (A), H1.1, H2.1, H3.1, H4.1, J1.2 (Ext), J2.4 (GND), J3.1 (Shield), J4.2 (Ext), R3.1, R4.1, R5.1, R11.2, R14.2, U1.29 (EP), U2.2 (GND), U3.2 (GND), U4.2 (GND), U5.2 (VSS), U6.1 (GND), U6.5 (GND), U6.10 (AGND), U6.11 (GND), U6.13 (TEST), U6.15 (GND), U6.25 (GND), U6.35 (GND), U6.47 (GND), U6.51 (GND), U7.4 (GND), U8.3 (GND), U9.10 (GND), U9.13 (D4), U9.14 (D5), U9.17 (D6), U9.18 (D7), U10.10 (GND), U10.13 (D4), U10.14 (D5), U10.17 (D6), U10.18 (D7), U11.2 (GND), X1.4 (GND), X2.1 (GND), X3.2 (GND), X3.3 (GND), X3.5 (GND)
unnamed: C2.1, R1.2
unnamed: D1.1 (K), R19.1
unnamed: C30.1, D2.1 (K), J2.1 (VBUS), U4.1 (IN), U4.3 (EN)
unnamed: C46.1, D6.1 (K), J4.1 (In)
unnamed: J2.5 (Shield), R11.1
unnamed: C11.2, U1.16 (CLKOUT)
unnamed: C1.1, R1.1, TP4.1, U1.12 (CPOUT)
unnamed: C10.2, U1.15 (XTAL)
unnamed: C22.2, C47.1, U2.4 (NR/FB)
unnamed: C26.2, C48.1, U3.4 (NR/FB)
unnamed: R16.1, U5.4 (CLK), U6.62 (EECLK)
unnamed: R15.1, U5.5 (CS), U6.63 (EECS)
unnamed: R12.1, U5.3 (DI), U6.61 (EEDATA)
unnamed: R12.2, R18.1, U5.1 (DO)
unnamed: U6.2 (OSCI), X2.5 (OUT)
unnamed: R14.1, U6.6 (REF)
unnamed: C33.1, C36.1, FB2.1, U6.4 (VPHY)
unnamed: C32.1, C35.1, FB1.1, U6.9 (VPLL)
unnamed: R17.1, U6.14 (~RESET)
unnamed: R20.1, R21.1, U11.1 (1A)
unnamed: U11.3 (2A), U11.6 (1Y)
unnamed: C10.1, X1.6 (CLK)
unnamed: R13.2, X2.3 (OE/NC)

Notes on the sheet:
MAX8510: C26<=10 nF, C48<=NL TPS717: C48<=10 nF, C26<=NL
R2 R3 R4 R5 R6 R7 R8 R9 R10 #1 0 NL 0 0 NL 0 NL NL NL Device State 2 #2 0 NL 0 NL 0 0 NL NL NL Device State 6 #3 NL 0 NL NL NL NL 0 0 0 Serial Interface
MAX8510: C22<=10 nF, C47<=NL TPS717: C47<=10 nF, C22<=NL
R20 R21 NL 0 FNHN 0 NL FNLN

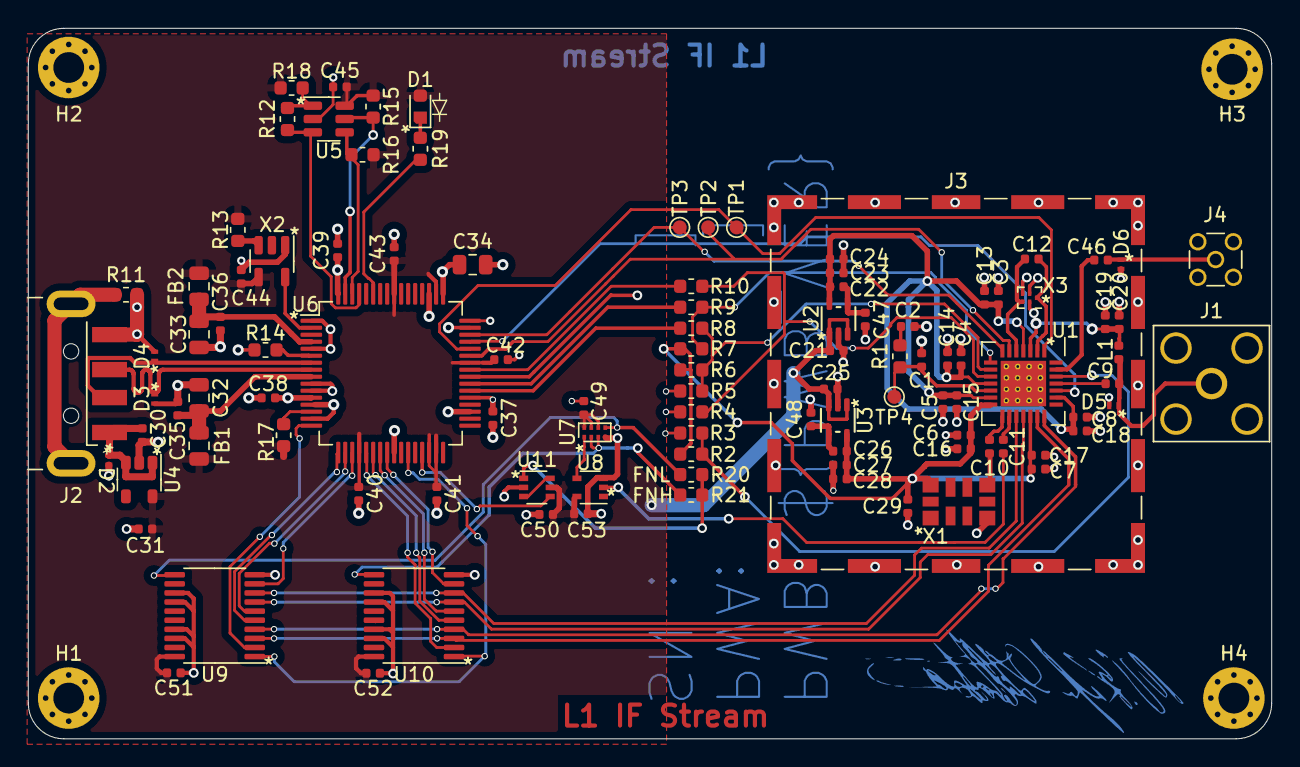
[picture p21: board L1IFStream.kicad_pcb from above]

Board: 4 copper layers, 88.9 x 50.8 mm, 110 parts (0 on the bottom side), 66 nets.

Other parts of the board:
QR*****: NAVSTARGPS.US
