WKyleGilbertson/L1IFStream/(commit log)

2023-06-19 First commit of L1 IF Stream Board
    [L1IFStream.kicad_pcb, L1IFStream.kicad_sch]
2023-06-19 Added Circuit protection diodes
    [L1IFStream.kicad_pcb, L1IFStream.kicad_sch]
2023-06-21 Added PMOD connector
    [L1IFStream.kicad_pcb, L1IFStream.kicad_sch]
2023-06-21 Added Tallysman Antenna Mount
    [L1IFStream.kicad_pcb, L1IFStream.kicad_sch]
2023-07-07 Clean up
    [L1IFStream.kicad_pcb]
2023-07-10 Added SMA and USB 3D model
    [L1IFStream.kicad_pcb]
2023-07-10 Added STEP files
    [1001-011-01101.STEP, L1IFStream.kicad_pcb, SMA-J-P-X-RA-TH1.step]
2023-07-10 Flip Clocks to Reorder Nibbles
    [L1IFStream.kicad_pcb, L1IFStream.kicad_sch]
2023-07-10 Prepare to make new card
    [L1IFStream.kicad_pcb, L1IFStream.kicad_sch]
2023-07-11 Cleaned up Qorvo footprint
    [L1IFStream.csv, L1IFStream.kicad_pcb, L1IFStream.kicad_sch]
2023-07-11 Verifying Footprints -- Qorvo and SiTime Checked, TVS needs minor tweaks
    [L1IFStream.kicad_pcb, L1IFStream.kicad_sch]
2023-07-12 All new parts identified on schematic. Need minor adjustments in layout.
    [L1IFStream.kicad_pcb, L1IFStream.kicad_sch]
2023-07-12 Ready for prototype quote
    [L1IFStream-B_Cu.gbr, L1IFStream-B_Mask.gbr, L1IFStream-B_Silkscreen.gbr, L1IFStream-Edge_Cuts.gbr, L1IFStream-F_Cu.gbr, L1IFStream-F_Mask.gbr, L1IFStream-F_Paste.gbr, L1IFStream-F_Silkscreen.gbr]
2023-07-12 Added Pick and Place File
    [L1IFStream-top-pos.csv]
2023-07-13 Added 3D model of QPQ1060SR
    [L1IFStream.kicad_pcb, QPQ1060SR.stp]
2023-07-14 Broke out MPN
    [L1IFStream.xlsx]
2023-07-14 Sent to 4PCB.com
    [L1IFStream.xlsx]
2023-07-14 Changed symbol properties for cleaner BOM generation
    [L1IFStream.csv, L1IFStream.kicad_sch, L1IFStream.xlsx]
2023-07-14 U11 should be unbuffered inverter. Should it be non-inverting?
    [L1IFStream.kicad_sch, L1IFStream.xlsx, L1IFStream_BOM.xlsx]
2023-07-14 Need to rework the symbol library
    [L1IFStream.csv, L1IFStream.kicad_sch, L1IFStream_BOM.xlsx]
2023-07-18 Added STEP files for some parts
    [DPY0002A.stp, L1IFStream.kicad_pcb, L1IFStream.kicad_sch, Oscillator_SMD_IDT_JS6-6_5.0x3.2mm_P1.27mm.step, QFN-28-1EP_5x5mm_P0.5mm_EP3.35x3.35mm.step, SOT-23-5.step, SOT-23-6.step, T-2P2W603942A-5sets-L1IFStream_BOM(2023-07-17-Corrected).xls]
2023-07-18 Added shield STEP file
    [L1IFStream.kicad_pcb, Laird-BMI-S-103-1.STEP]
2023-07-20 Changed solder mask minimum web width to 0.05 mm
    [L1IFStream-B_Cu.gbr, L1IFStream-B_Mask.gbr, L1IFStream-B_Silkscreen.gbr, L1IFStream-Edge_Cuts.gbr, L1IFStream-F_Cu.gbr, L1IFStream-F_Mask.gbr, L1IFStream-F_Paste.gbr, L1IFStream-F_Silkscreen.gbr]
2023-07-24 Sent parts to PCBway
    [L1IFStream.kicad_sch]
2023-07-24 Rotated schematic -- updated some footprints to use local library
    [L1IFStream.kicad_sch]
2023-07-25 Reoriented schematic
    [L1IFStream.kicad_pcb, L1IFStream.kicad_sch]
2023-08-01 Midway through prototype run at PCBWay
    [L1IFStream_BOM.xlsx]
2023-08-04 Initial commit of Antenna status checker
2023-08-08 Clean state until SPI addition
2023-08-09 Added SPI config and stuff to set GPS Clock rate, but haven't tested it.
2023-08-10 Changed Sample Speed, but SPI CS enable part does not look right
2023-08-10 Removed SPI sample rate adjustment
2023-08-10 Decoding the SPI bus interface
2023-08-11 Still mirky on the SPI direction mask, but it seems to be working
2023-08-11 Moved SPI programming stuff around
2023-08-11 Files sent to PCBWay to test boards
2023-08-11 Not sure what changed here other than setting visibility of layers
    [L1IFStream.kicad_pcb]
2023-10-20 Got L1IFStat to run on pilot run from PCBWAY
2023-10-20 Renamed flash template to avoid conflict with BOM intermediary file
2023-10-21 Fixed LED Circuit
    [L1IFStream.kicad_sch]
2023-10-21 Added test points to attach SPI device
    [L1IFStream.kicad_pcb, L1IFStream.kicad_sch]
2023-10-24 Debating how much to fix. Current Argument, just the LED circuit
    [L1IFStream.kicad_pcb, L1IFStream.kicad_sch]
2023-10-26 Need to cleanup library for Macrofab compatibility
    [L1IFStream.kicad_pcb]
2023-11-01 Squared up L1IFTHMB and L1IFStream to implement the same nibble selector
    [L1IFStream.kicad_pcb, L1IFStream.kicad_sch]
2023-11-07 Started cleaning up symbol library
    [L1IFStream.kicad_pcb, L1IFStream.kicad_sch]
2023-11-09 Library clean up of oscillators and U1
    [L1IFStream.kicad_pcb, L1IFStream.kicad_sch]
2023-11-09 Cleaned up library through U3
    [DCK0005A.stp, L1IFStream.csv, L1IFStream.kicad_pcb, L1IFStream.kicad_sch]
2023-11-09 Library clean up through U4
    [L1IFStream.kicad_pcb, L1IFStream.kicad_sch]
2023-11-09 Updated U4 to Library part
    [L1IFStream.kicad_sch]
2023-11-13 Library cleaned up except for Rs and Cs
    [L1IFStream.kicad_pcb, L1IFStream.kicad_sch, LQFP-64_10x10mm_P0.5mm.step, MMCX_Molex_73415-1471_Vertical.step, SOT-353_SC-70-5.step, SOT-363_SC-70-6.step, SOT833-1.step, TSSOP-20_4.4x6.5mm_P0.65mm.step]
2023-11-13 Library cleanup capacitors
    [L1IFStream.kicad_sch]
2023-11-13 Capacitor silk placement
    [L1IFStream.kicad_pcb]
2023-11-14 Library cleaned up through resistors. Just caps to go.
    [L1IFStream.kicad_pcb, L1IFStream.kicad_sch]
2023-11-14 Library Cleaned Up
    [L1IFStream.kicad_pcb, L1IFStream.kicad_sch]
2023-11-14 Seemingly ready to make more
    [L1IFStream.xlsx, L1IFStream_BOM.xlsx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]
2023-11-14 Should only need L1IF symbol and footprints now.
2023-11-16 Added SiTime 5156 16.367667 oscillator as alternate.
    [L1IFStream.kicad_sch]
2023-11-16 Cleaned up some routes and separated grounds.
    [L1IFStream.kicad_pcb]
2023-12-04 Changed License to CERN-OHL-W v2
    [L1IFStream.kicad_pcb, L1IFStream.kicad_sch]
2024-02-13 Added standoff dimensions and moved fiducial targets
    [L1IFStream.kicad_pcb]
2024-02-13 Minor drawing cleanup with more needed
    [L1IFStream.kicad_sch]
2024-02-13 Revert "Files sent to PCBWay to test boards"
    This reverts commit 74a9a0324716ddeedc07c467053088ec7fdbbe32.
