WKyleGilbertson/L1IFStream/(notices)

Notices in the files:
Card/STEP/LQFP-64_10x10mm_P0.5mm.step:
Copyright (C) 2017, kicad StepUp
This work is licensed under the [Creative Commons CC-BY-SA 4.0 License](https://creativecommons.org/licenses/by-sa/4.0/legalcode),
with the following exception:
To the extent that the creation of electronic designs that use 'Licensed Material' can be considered to be 'Adapted Material',
You are free to use the library data in your own projects without the obligation to share your project files under this or any other license agreement.
Card/STEP/QFN-28-1EP_5x5mm_P0.5mm_EP3.35x3.35mm.step:
This program is free software: you can redistribute it and/or modify
it under the terms of the GNU General Public License as published by
the Free Software Foundation, either version 3 of the License, or
any later version.
itself might be covered by the GNU General Public License.
Card/L1IFStream.kicad_sch:
https://cern.ch/cern-ohl
License: CERN-OHL-W-2.0
